zaineb-trigui/pfa-nettoyage-panneaux-pv/images/la photo du montage électronique.jpeg

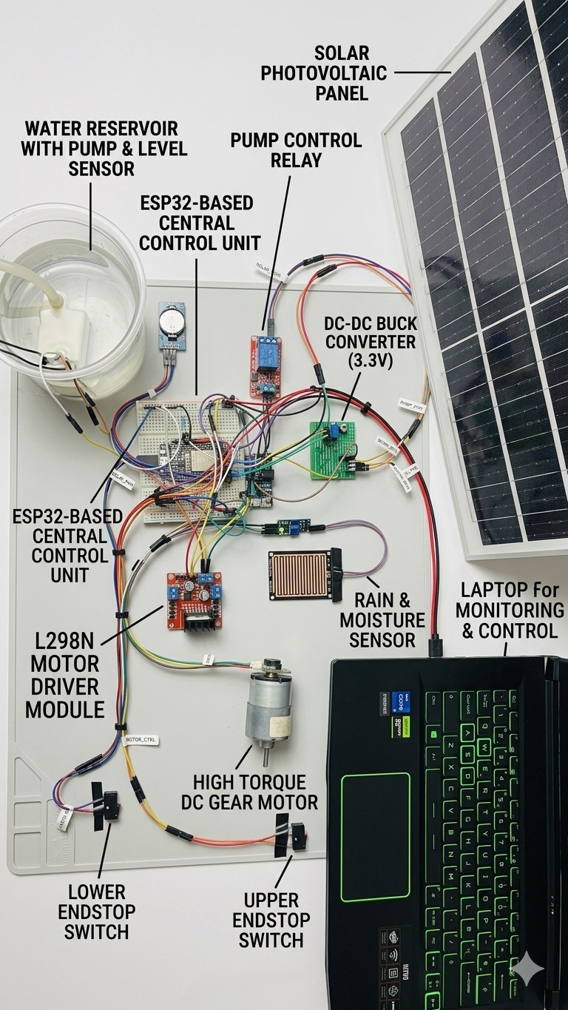
images/la photo du montage électronique.jpeg
