zaineb-trigui/pfa-nettoyage-panneaux-pv/images/la vue 3D du panneau.jpeg

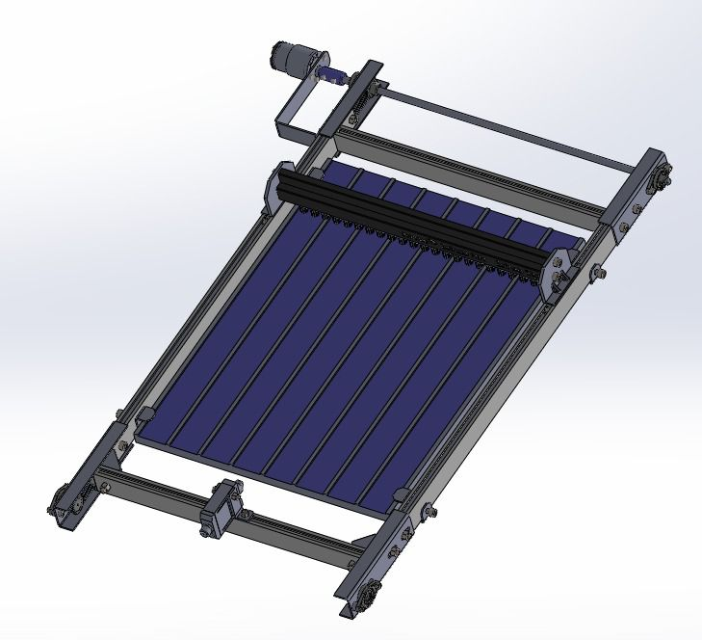
images/la vue 3D du panneau.jpeg
