zaineb-trigui/pfa-nettoyage-panneaux-pv/docs/CONCEPTION ET CRÉATION D'UN SYSTÈME DE NETTOYAGE AUTOMATIQUE DES PANNEAUX PHOTOVOLTAÏQUES.pptx

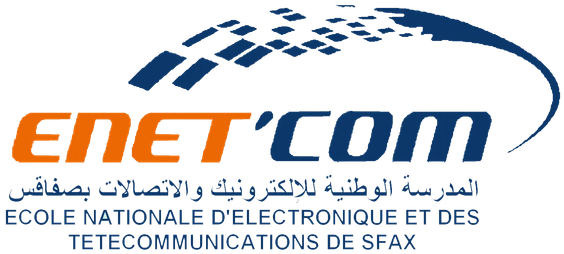
[picture p3: figure]

2ème année Génie des Systèmes Electroniques de
Communication

Rébuplique Tunisienne
Ministère de l’Enseignement Supérieur
et de la Recherche Scientifique
*** ***
Université de Sfax
Ecole Nationale d’Electronique et des Télécommunications de Sfax

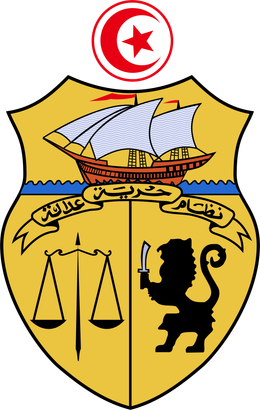
[picture p4: figure]
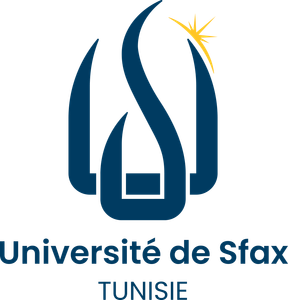
[picture p5: figure]

CONCEPTION ET CRÉATION D'UN SYSTÈME DE NETTOYAGE AUTOMATIQUE DES PANNEAUX PHOTOVOLTAÏQUES

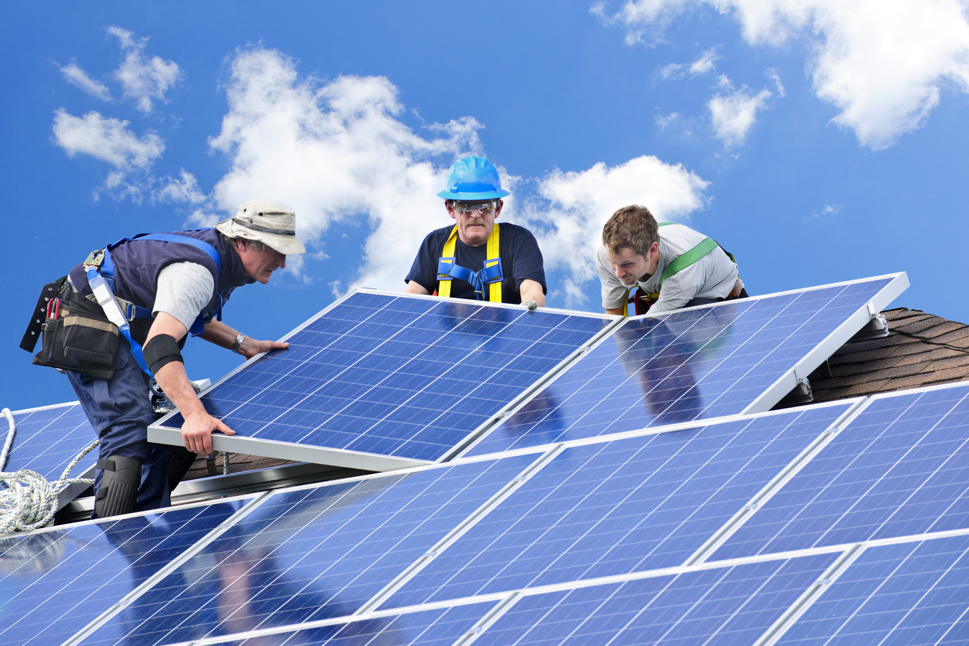
[picture p6: figure]
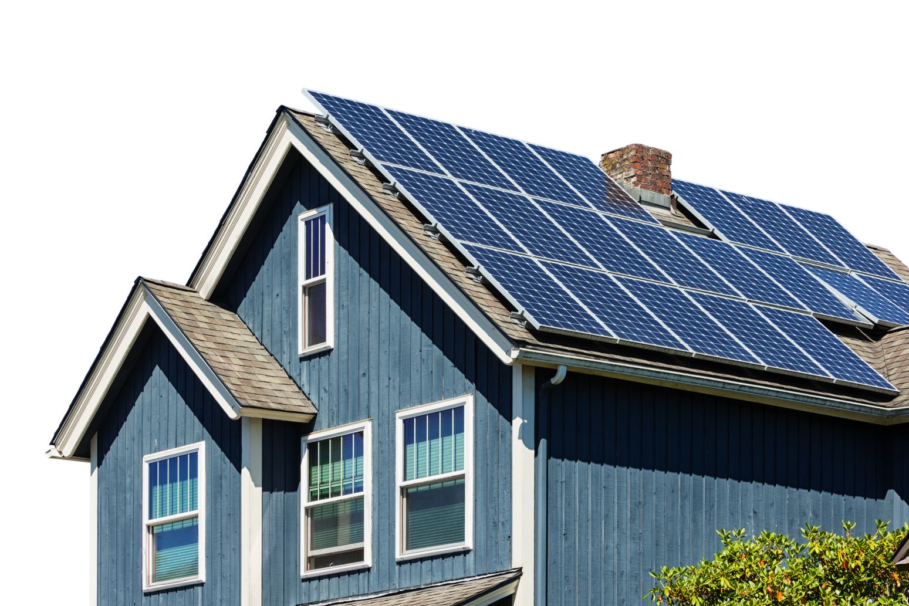
[picture p7: figure]

ENCADRÉ PAR:
MR.NIDHAL BEN AMOR

EXAMINÉ PAR :
MME. NEDIA CHAKER

ELABORÉ PAR:
ZAINAB FRITIS
ZAINEB TRIGUI

ENET'COM SFAX | PROJET FIN D’ANNÉE | AVRIL 2026

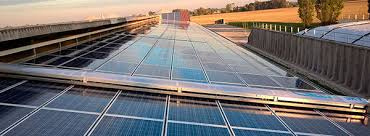
[picture p8: figure]

## Slide 2

PLAN DE LA PRÉSENTATION

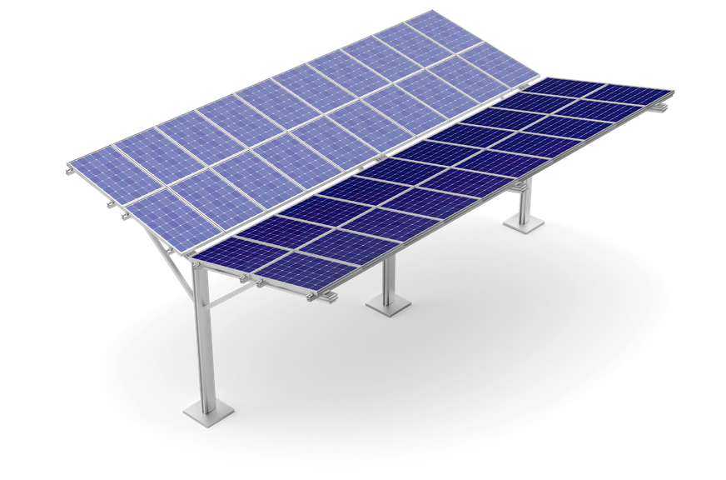
[picture p9: figure]
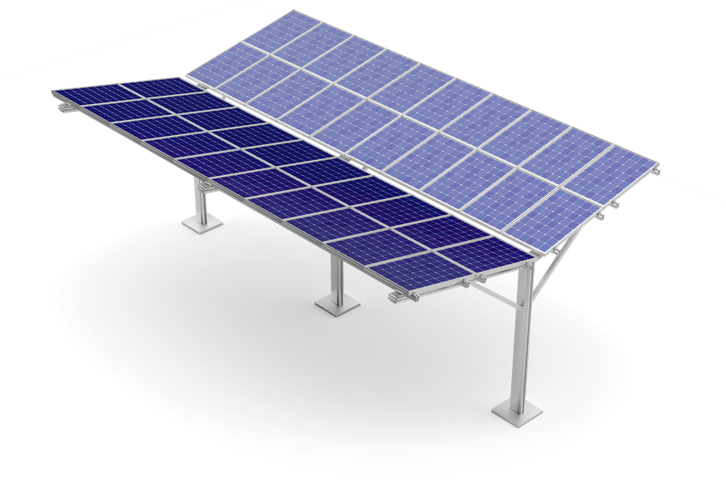
[picture p10: figure]

1

CONTEXTE & PROBLÉMATIQUE

ARCHITECTURE DU SYSTÈME

CONCEPTION MATÉRIELLE

4

CONCEPTION LOGICIELLE

TESTS & RÉSULTATS

CONCLUSION & PERSPECTIVES

2

5

3

6

ENET'COM SFAX | ZAINAB FRITIS & ZAINEB TRIGUI | AVRIL 2026

1

## Slide 3

Contexte

& PROBLÉMATIQUE

Sustainability

Problème actuel

•Nettoyage manuel coûteux
•Risque pour le personnel
•Irrégulier → pertes continues
•Pas de détection automatique

2800h

ensoleillement/an
en Tunisie

40%

perte rendement
poussière

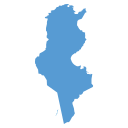
[picture p11: figure]

Notre solution : Système automatique ESP32 + WiFi + Capteurs de sécurité

ENET'COM SFAX | ZAINAB FRITIS & ZAINEB TRIGUI | AVRIL 2026

2

## Slide 4

LES DIFFÉRENTS SYSTÈMES INTÉLLIGENTS DE NETTOYAGE DE PANNEAUX SOLAIRES

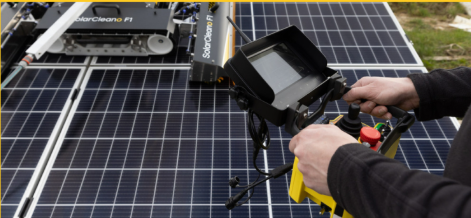
[picture p12: figure]
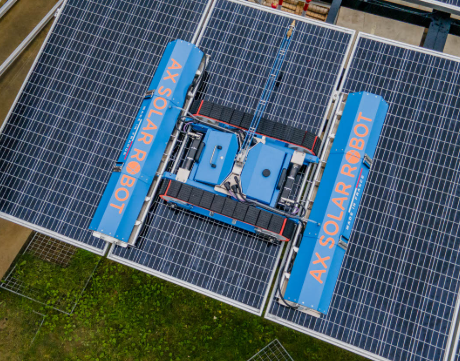
[picture p13: figure]
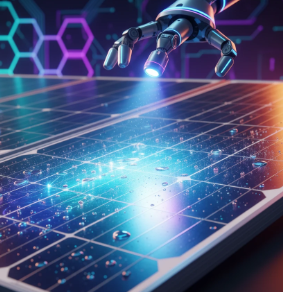
[picture p14: figure]

Robot Semi-Automatique

  - Coût élevé (10–30 k€)
  - opérateur requis
  - peu adapté aux petites/moyennes installations.

ENET'COM SFAX | ZAINAB FRITIS & ZAINEB TRIGUI | AVRIL 2026

Robot Autonome IA

  - Coût élevé
  - Maintenance complexe
  - Importation coûteuse
  - Surdimensionné

Panneaux Autonettoyants (Nanotechnologie)

  - Non disponibles
  - Coût incertain
  - Non compatibles

3

## Slide 5

NOTRE SOLUTION !

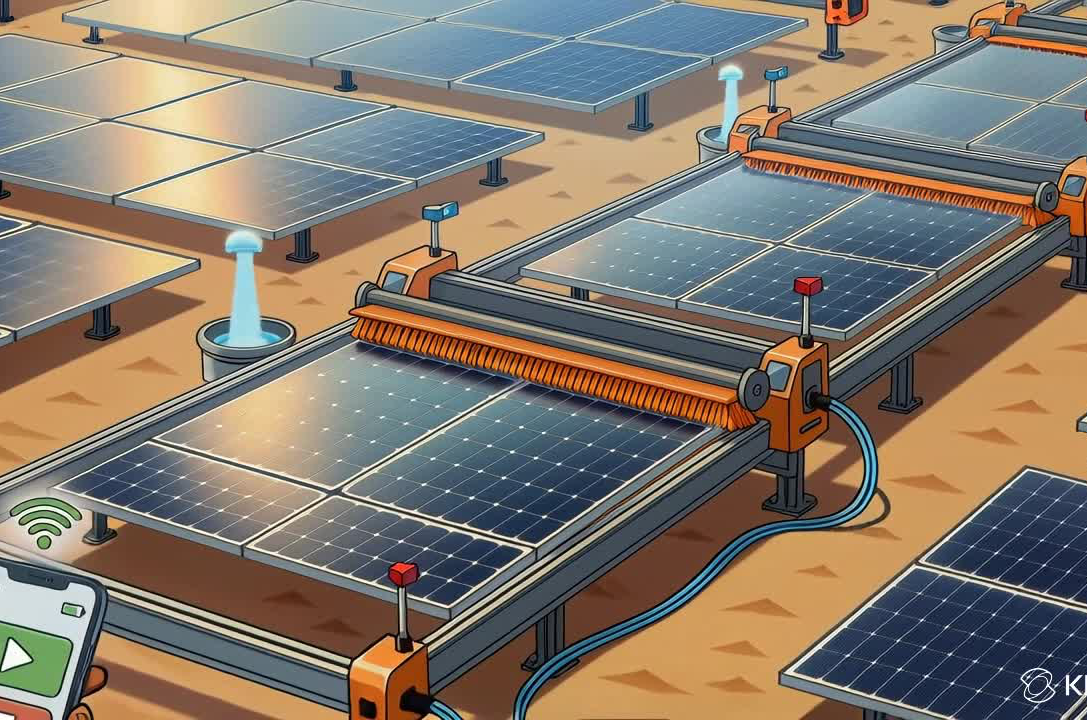
[picture p15: figure]

Coût accessible

Scalable

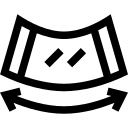
[picture p16: figure]
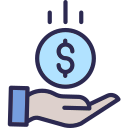
[picture p17: figure]

Sécurité totale

Contrôle à distance

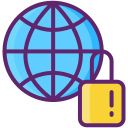
[picture p18: figure]
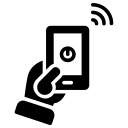
[picture p19: figure]

ENET'COM SFAX | ZAINAB FRITIS & ZAINEB TRIGUI | AVRIL 2026

4

## Slide 6

Architecture du système

ENET'COM SFAX | ZAINAB FRITIS & ZAINEB TRIGUI | AVRIL 2026

5

## Slide 7

ARCHITECTURE DU SYSTÈME

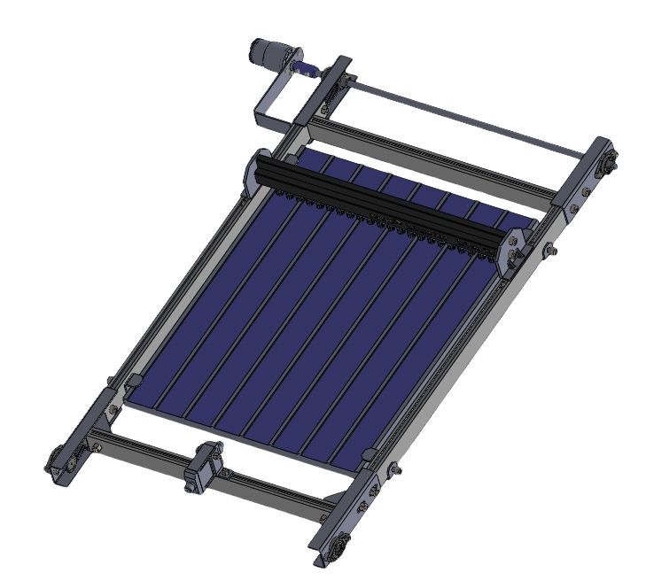
[picture p20: figure]

Schéma mécanique — SolidWorks 2025

ENET'COM SFAX | ZAINAB FRITIS & ZAINEB TRIGUI | AVRIL 2026

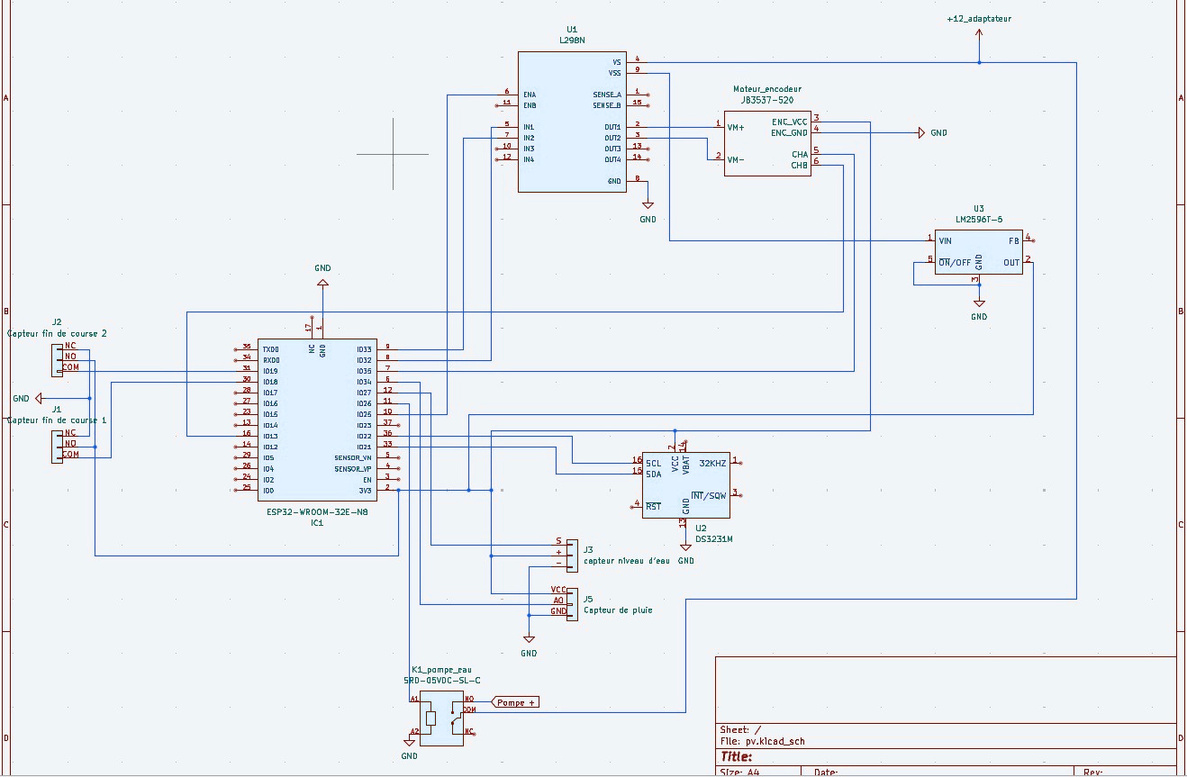
[picture p21: figure]

Schéma électronique — KiCad 9.0

6

## Slide 8

ARCHITECTURE DU SYSTÈME

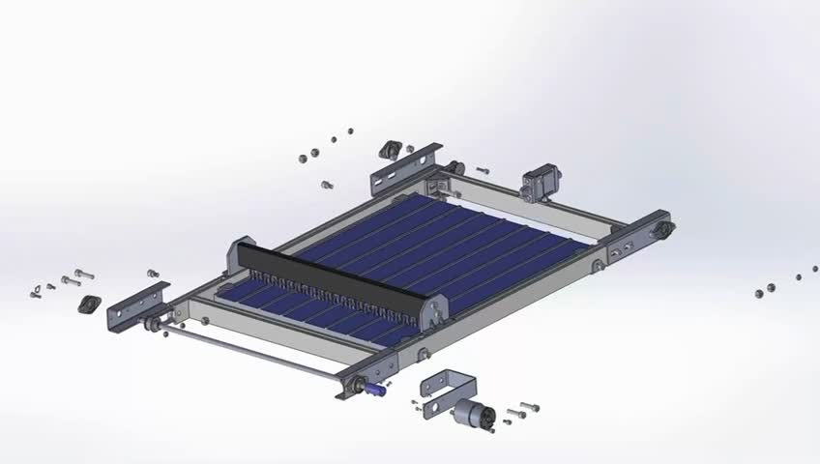
[picture p22: figure]

Schéma mécanique — SolidWorks 2025

ENET'COM SFAX | ZAINAB FRITIS & ZAINEB TRIGUI | AVRIL 2026

7

## Slide 9

Conception matérielle

ENET'COM SFAX | ZAINAB FRITIS & ZAINEB TRIGUI | AVRIL 2026

8

## Slide 10

CONCEPTION MATÉRIELLE

PRINCIPAUX

Composants

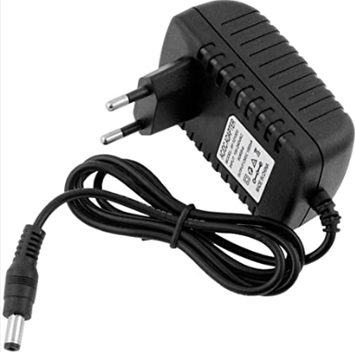
[picture p23: figure]

Adaptateur (https://www.cdsecurity.tn/shop/adaptateur-alimentation-dc-12v-12) alimentation DC 12V (https://www.cdsecurity.tn/shop/adaptateur-alimentation-dc-12v-12)

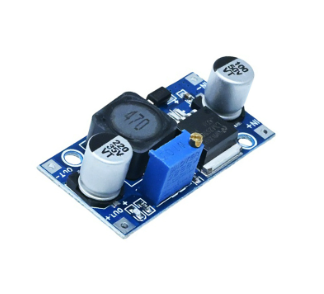
[picture p24: figure]

convertisseur (https://www.cdsecurity.tn/shop/adaptateur-alimentation-dc-12v-12) buck lm2596 (https://www.cdsecurity.tn/shop/adaptateur-alimentation-dc-12v-12)

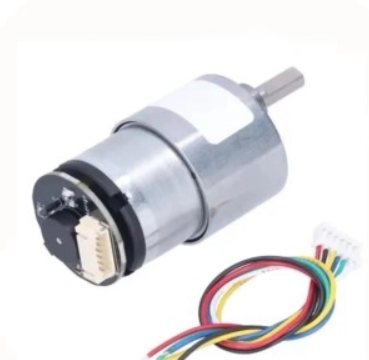
[picture p25: figure]

moteur a encodeur JGB37

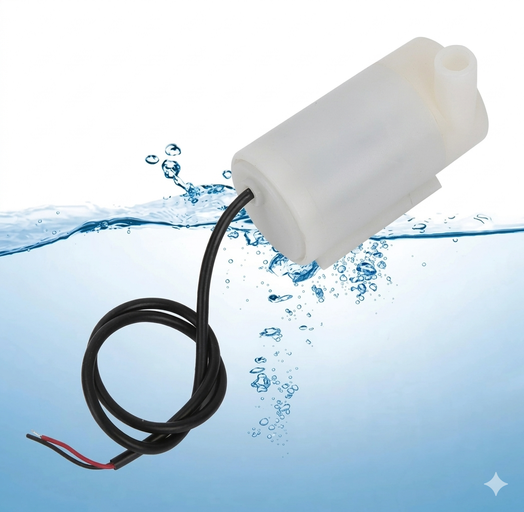
[picture p26: figure]

pompe

ENET'COM SFAX | ZAINAB FRITIS & ZAINEB TRIGUI | AVRIL 2026

9

## Slide 11

CONCEPTION MATÉRIELLE

PILOTAGE

Composants de

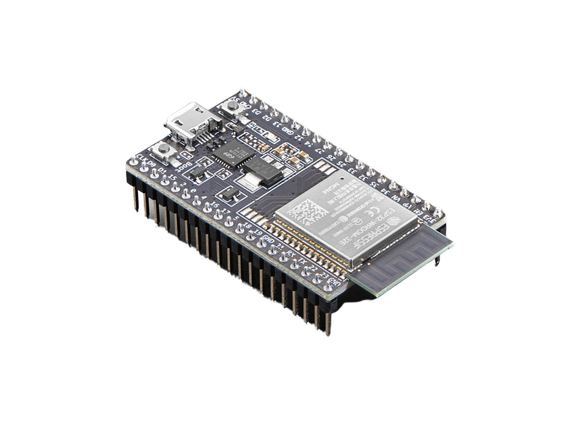
[picture p27: figure]

ESP32

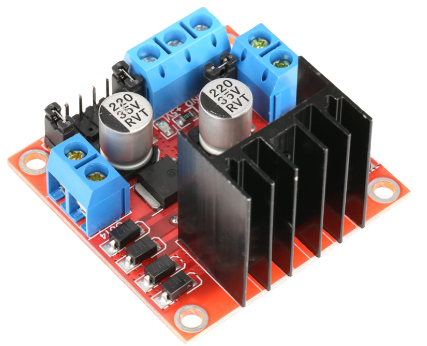
[picture p28: figure]

Driver moteur (L298N)

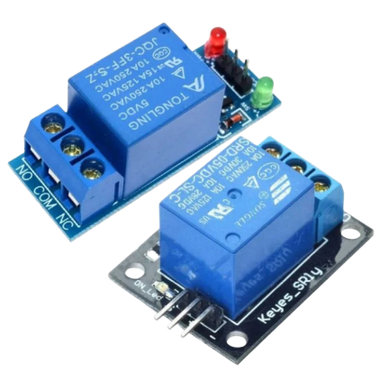
[picture p29: figure]

Relais

ENET'COM SFAX | ZAINAB FRITIS & ZAINEB TRIGUI | AVRIL 2026

10

## Slide 12

CONCEPTION MATÉRIELLE

CAPTEURS

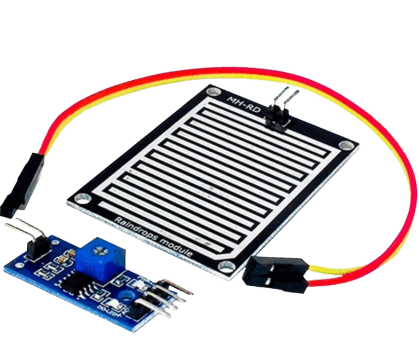
[picture p30: figure]

Capteur de
Pluie

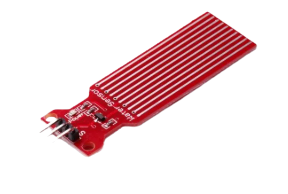
[picture p31: figure]

Capteur de
Niveau d'Eau

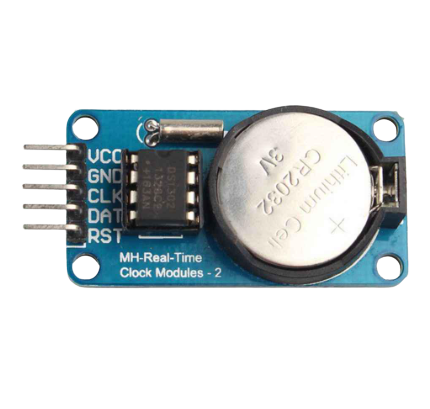
[picture p32: figure]

Module RTC
(DS1307)

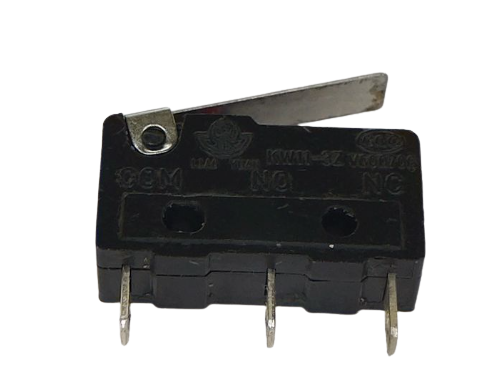
[picture p33: figure]

Micro-switch
(Fin de course)

ENET'COM SFAX | ZAINAB FRITIS & ZAINEB TRIGUI | AVRIL 2026

11

## Slide 13

Conception logicielle

ENET'COM SFAX | ZAINAB FRITIS & ZAINEB TRIGUI | AVRIL 2026

12

## Slide 14

CONCEPTION LOGICIELLE

PROGRAMMATION

Logiciels de

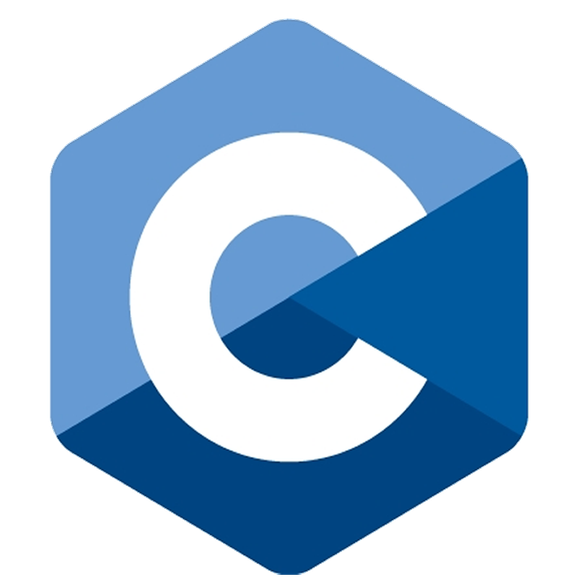
[picture p34: figure]
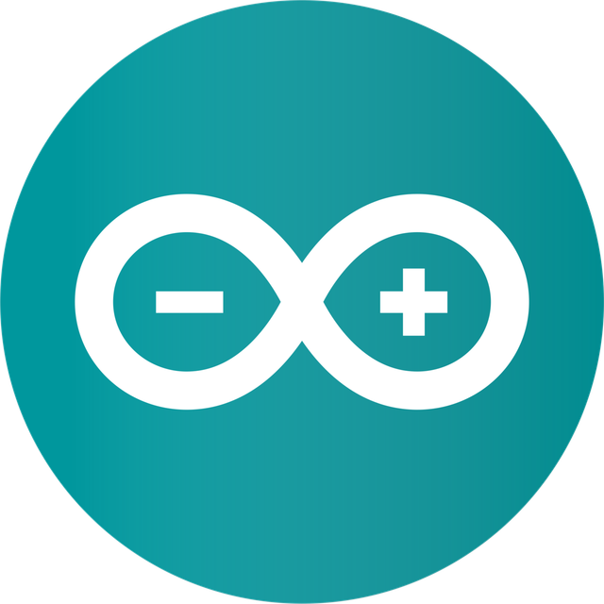
[picture p35: figure]

Arduino IDE

Environnement de développement

Langage C++

Langage principal pour ESP32

ENET'COM SFAX | ZAINAB FRITIS & ZAINEB TRIGUI | AVRIL 2026

13

## Slide 15

CONCEPTION LOGICIELLE

CONCEPTION

Logiciels de

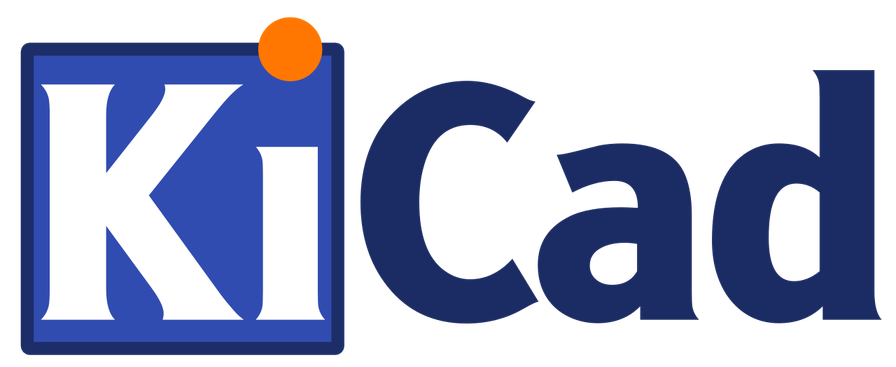
[picture p36: figure]

Création de schémas électroniques

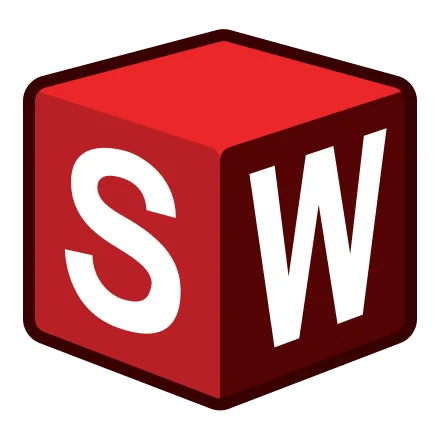
[picture p37: figure]

SolidWorks

Modélisation de pièces et assemblages 3D

KiCad

ENET'COM SFAX | ZAINAB FRITIS & ZAINEB TRIGUI | AVRIL 2026

14

## Slide 16

Tests
&
Résultats

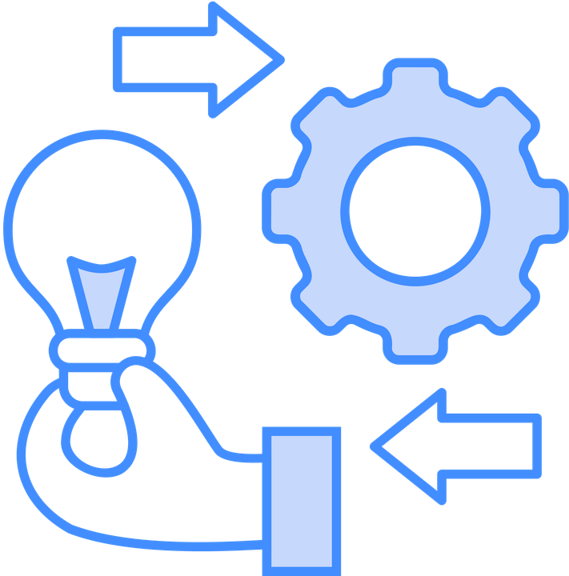
[picture p38: figure]

ENET'COM SFAX |ZAINAB FRITIS & ZAINEB TRIGUI| AVRIL 2026

15

## Slide 17

TESTS & RÉSULTATS

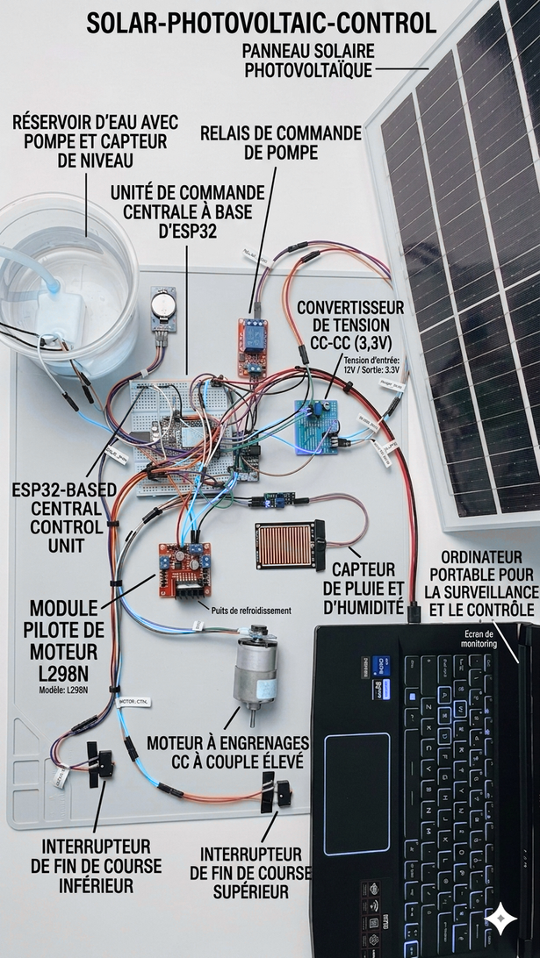
[picture p39: figure]

CABLAGE
ET INTERCONNEXIONS

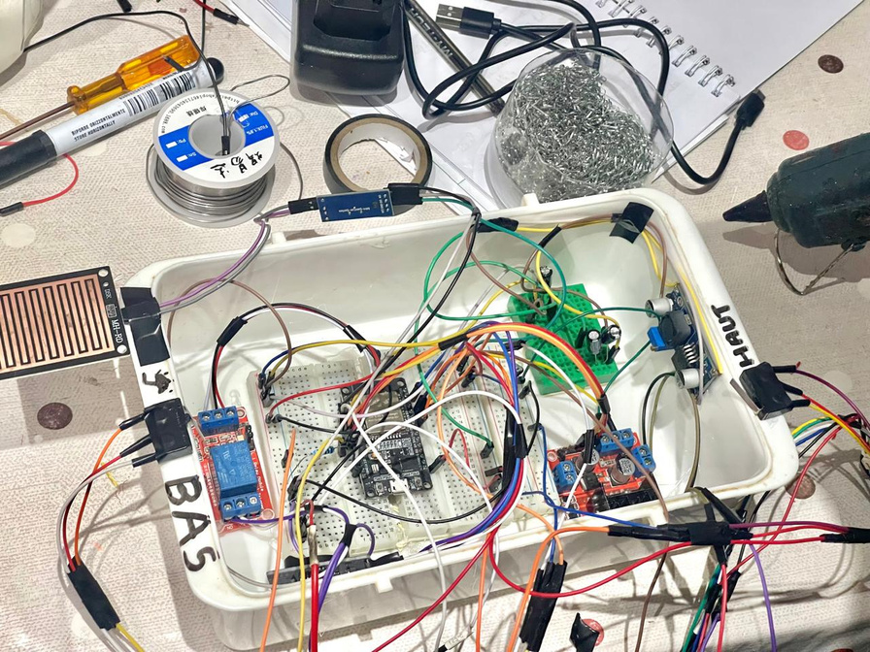
[picture p40: figure]

prototype final en cours de test

ENET'COM SFAX |ZAINAB FRITIS & ZAINEB TRIGUI| AVRIL 2026

16

## Slide 18

TESTS & RÉSULTATS

SCHÈMA BLOC :

LM2596

12V

Source 12V DC

12V

DS3231 RTC

Module d’acquisition

L298N + Moteur DC

Capteur pluie J5

Données

3.3V

Capteur niveau d’eau J3

ESP32-WROOM-32E-N8

Unité de traitement

Module de puissance

Commandes

Encodeur JGB37

Module rétroaction & sécurité

Fins de course

Rétroaction

Relais + Pompe 12V

ENET'COM SFAX | ZAINAB FRITIS & ZAINEB TRIGUI | AVRIL 2026

17

## Slide 19

TESTS & RÉSULTATS

ALGORITHME DE DÉCISION

ENET'COM SFAX |ZAINAB FRITIS & ZAINEB TRIGUI| AVRIL 2026

01

02

03

04

Condition temporelle

déclenchement à une heure donnée

Condition hydraulique

ADC > seuil ⇒ eau suffisante

Condition météorologique

Pluie détectée ⇒ nettoyage annulé

Anti-redondance

un seul cycle par minute (dejaExecute)

18

## Slide 20

TESTS & RÉSULTATS

Etat 1

Attente FDC haut

motorAvant(150)

FDC_Haut = ‘ HIGH ’

FDC_Haut = ‘ LOW ’

Etat 0

MONTEE

motorAvant(150)

Etat 2

DESCENTE

motorArrière(150)

Etat 3

Fin de cycle

motorStop()

Si le nombre de cycle < 5

FDC_Haut = ‘ HIGH ’

MACHINE À ÉTATS DE LA SÉQUENCE DE NETTOYAGE

ENET'COM SFAX |ZAINAB FRITIS & ZAINEB TRIGUI| AVRIL 2026

19

## Slide 21

TESTS & RÉSULTATS

MÉCANISMES DE SÉCURITÉ

01

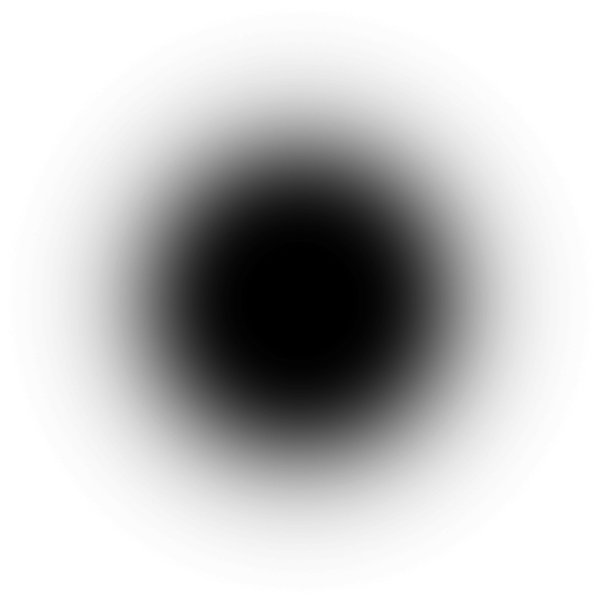
[picture p41: figure]

Détecrion d’obstacle par l’encodeur

pas d’impulsions (3 s)
⇒ arrêt moteur + pompe + redémarrage ESP32

ENET'COM SFAX |ZAINAB FRITIS & ZAINEB TRIGUI| AVRIL 2026

02

Watchdog (15 s)

redémarrage automatique en cas de blocage du système

20

## Slide 22

TESTS & RÉSULTATS

TESTS UNITAIRES DES COMPOSANTS

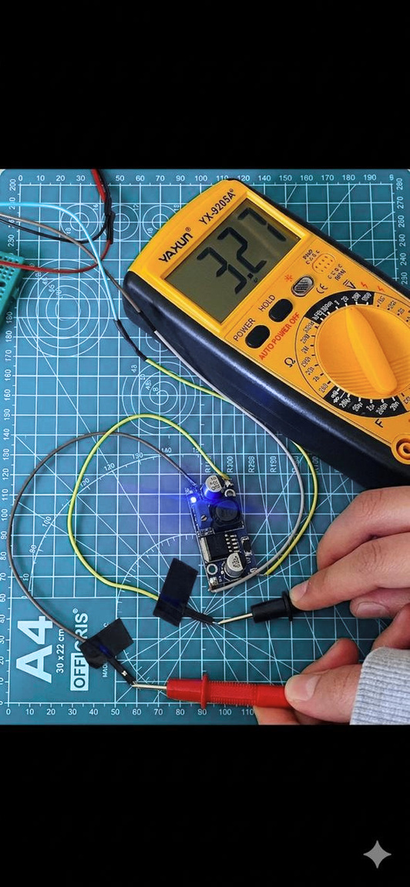
[picture p42: figure]

test unitaire électrique

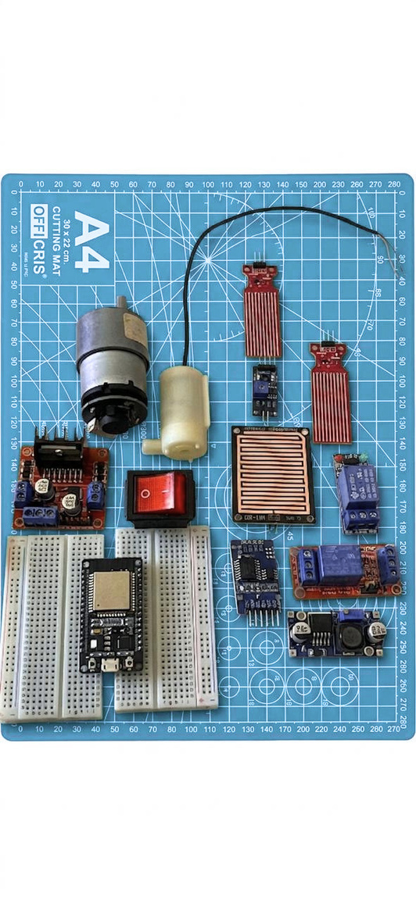
[picture p43: figure]

avant assemblage

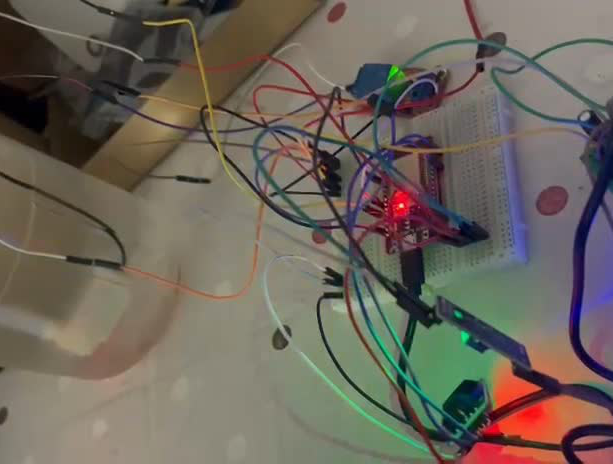
[picture p44: figure]

ENET'COM SFAX |ZAINAB FRITIS & ZAINEB TRIGUI| AVRIL 2026

21

## Slide 23

TESTS & RÉSULTATS

RÉSULTATS DU TEST D’INTÉGRATION FINAL

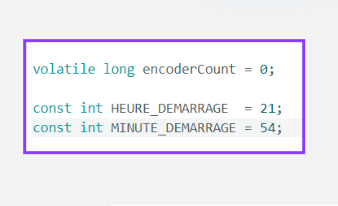
[picture p45: figure]

Automatisation du système

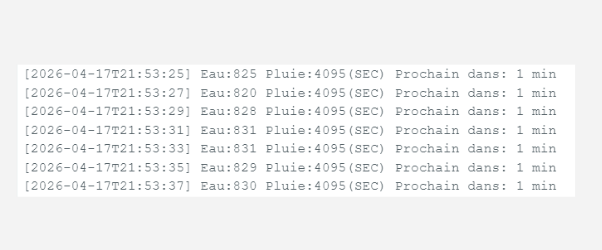
[picture p46: figure]

ENET'COM SFAX |ZAINAB FRITIS & ZAINEB TRIGUI| AVRIL 2026

22

## Slide 24

TESTS & RÉSULTATS

RÉSULTATS DU TEST D’INTÉGRATION FINAL

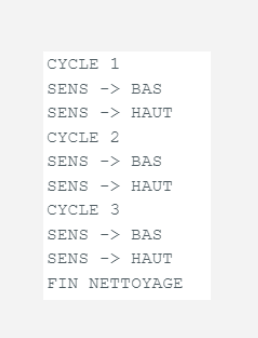
[picture p47: figure]
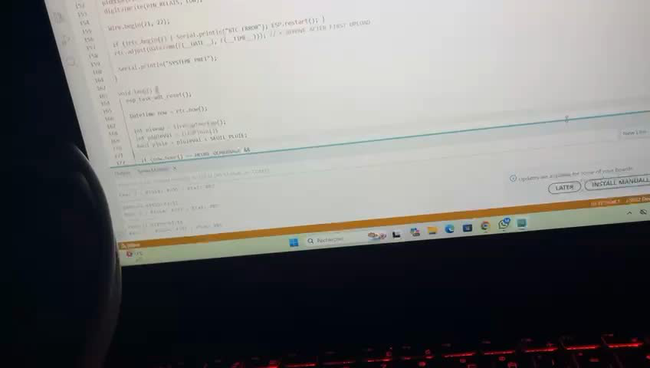
[picture p48: figure]

TEST FINAL

ENET'COM SFAX |ZAINAB FRITIS & ZAINEB TRIGUI| AVRIL 2026

23

## Slide 25

Conclusion
& Perspectives

ENET'COM SFAX | ZAINAB FRITIS & ZAINEB TRIGUI | AVRIL 2026

24

## Slide 26

CONCLUSION & PERSPECTIVES

CONCLUSION

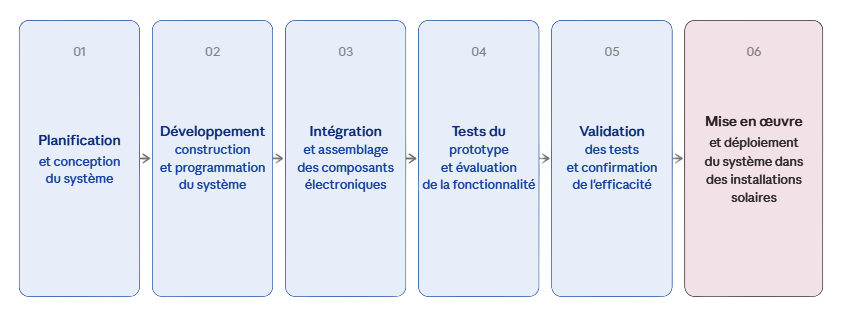
[picture p49: figure]
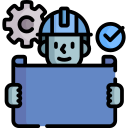
[picture p50: figure]
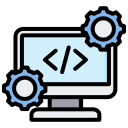
[picture p51: figure]
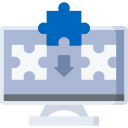
[picture p52: figure]
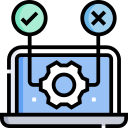
[picture p53: figure]
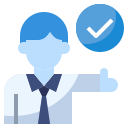
[picture p54: figure]

ENET'COM SFAX |ZAINAB FRITIS & ZAINEB TRIGUI| AVRIL 2026

25

## Slide 27

CONCLUSION & PERSPECTIVES

PERSPECTIVES

Optimisation de la consommation d'eau

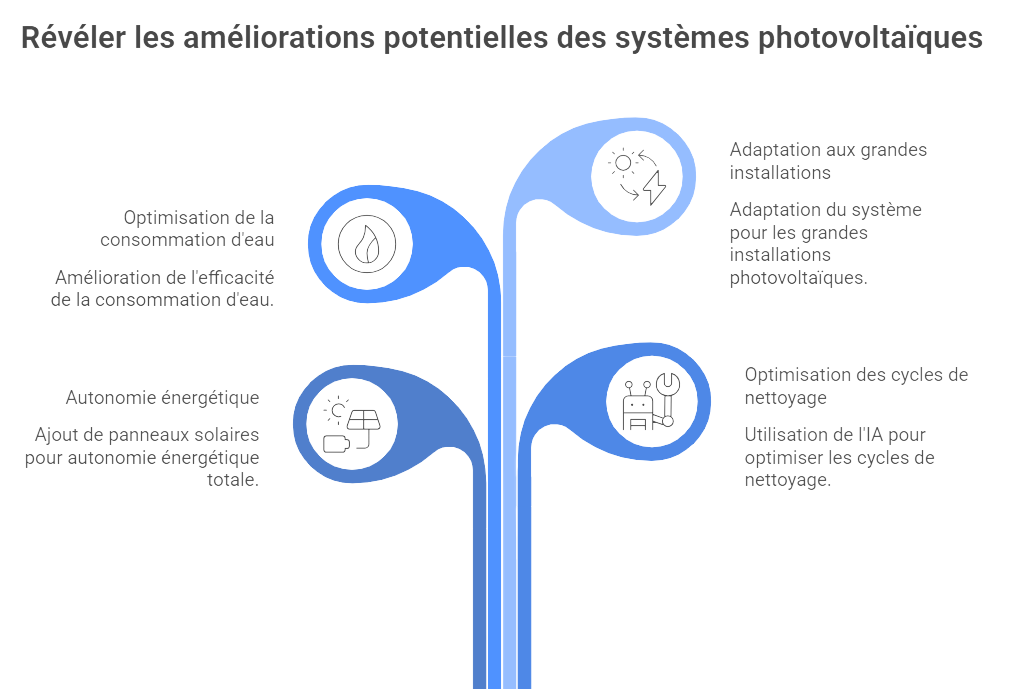
[picture p55: figure]

Adaptation aux grandes installations

Optimisation des cycles de nettoyage

Autonomie énergétique

ENET'COM SFAX |ZAINAB FRITIS & ZAINEB TRIGUI| AVRIL 2026

26

## Slide 28

RÉFÉRENCES BIBLIOGRAPHIQUES

datasheets

  - LM2596 — Buck converter step-downTI (official): https://www.ti.com/lit/ds/symlink/lm2596.pdf
  - JGB37-520 — Moteur DC avec encodeur
https://c1555f5ec9.clvaw-cdnwnd.com/34662fcf1f1e607c561442431023ac8e/200013049-b3a11b3a13/JGB37-520%20Datasheet.pdf
  - DS1307 — Module RTC Analog Devices (official): https://www.analog.com/media/en/technical-documentation/data-sheets/ds1307.pdf
  - ESP32
https://www.espressif.com/sites/default/files/documentation/esp32_datasheet_en.pdf
  - L298N
https://www.st.com/resource/en/datasheet/l298.pdf

Recherches externes

SolidWorks Tutorial (https://www.mathworks.com/help/matlab/getting-started-with-matlab.html)

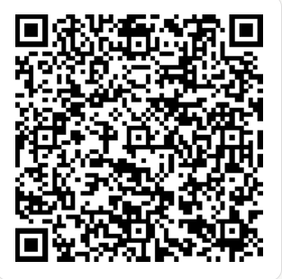
[picture p56: figure]

Exemple réel (https://unframework.github.io/dtmf-detect/)

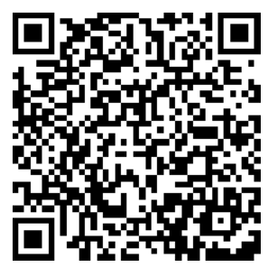
[picture p57: figure]

GrabCad

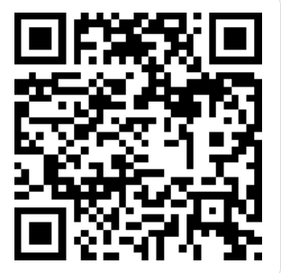
[picture p58: figure]

ENET'COM SFAX |ZAINAB FRITIS & ZAINEB TRIGUI| AVRIL 2026

27

## Slide 29

merci pour votre attention!

ENET'COM SFAX |ZAINAB FRITIS & ZAINEB TRIGUI| AVRIL 2026
