zaineb-trigui/pfa-nettoyage-panneaux-pv/images/la vue éclatée.jpeg

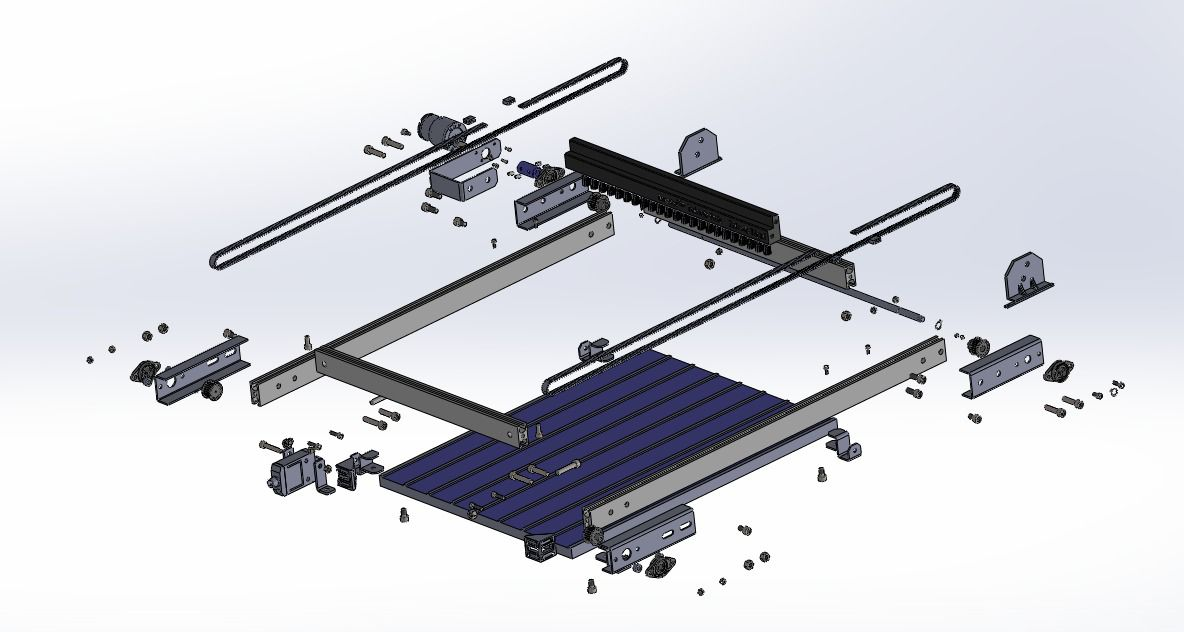
images/la vue éclatée.jpeg
