zaineb-trigui/pfa-nettoyage-panneaux-pv/images/l’organigramme.jpeg

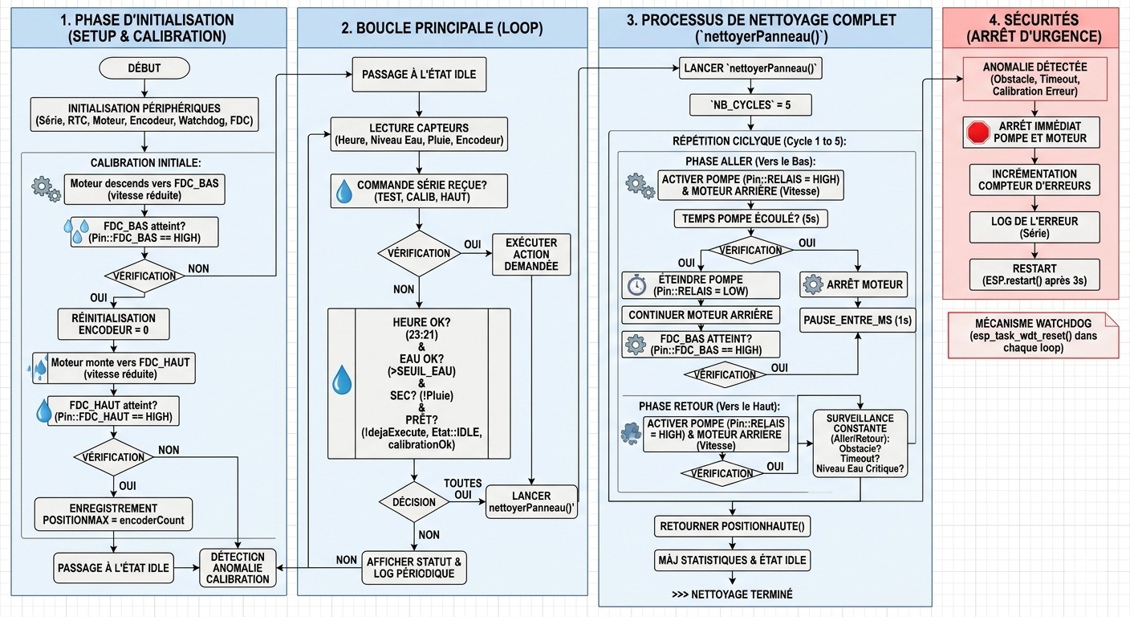
images/l’organigramme.jpeg
