zaineb-trigui/pfa-nettoyage-panneaux-pv/hardware/solidworks/Conception Panel Solar/Solar panel cleaning machine.SLDPRT

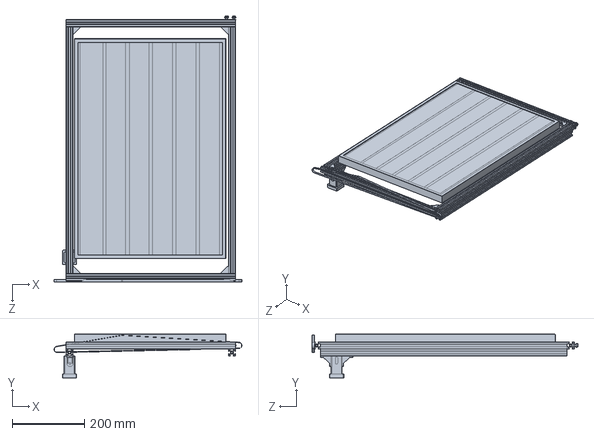
[picture p83: CAD file, 2026-10-17]
hardware/solidworks/Conception Panel Solar/Solar panel cleaning machine.SLDPRT
521.4 x 121.0 x 738.2 mm
